Tsukoyachi/Domotech/code/Readme.md

Les librairies requises pour faire fonctionner le code "/Domotech_final/src/main.cpp" qui est actuellement la dernière version de notre projet sont les suivantes :
 - Adafruit Unified Sensor by Adafruit
 - DHT sensor library by Adafruit
 - ESP32Servo by Kevin Harrington
 - BH1750
 - AsyncTCP-esphome by Hristo Gochkov
 - ESPAsyncWebServer-esphome by ESPHome Team
