Tsukoyachi/Domotech/Oral final du projet/Présentation projet arduino.pptx

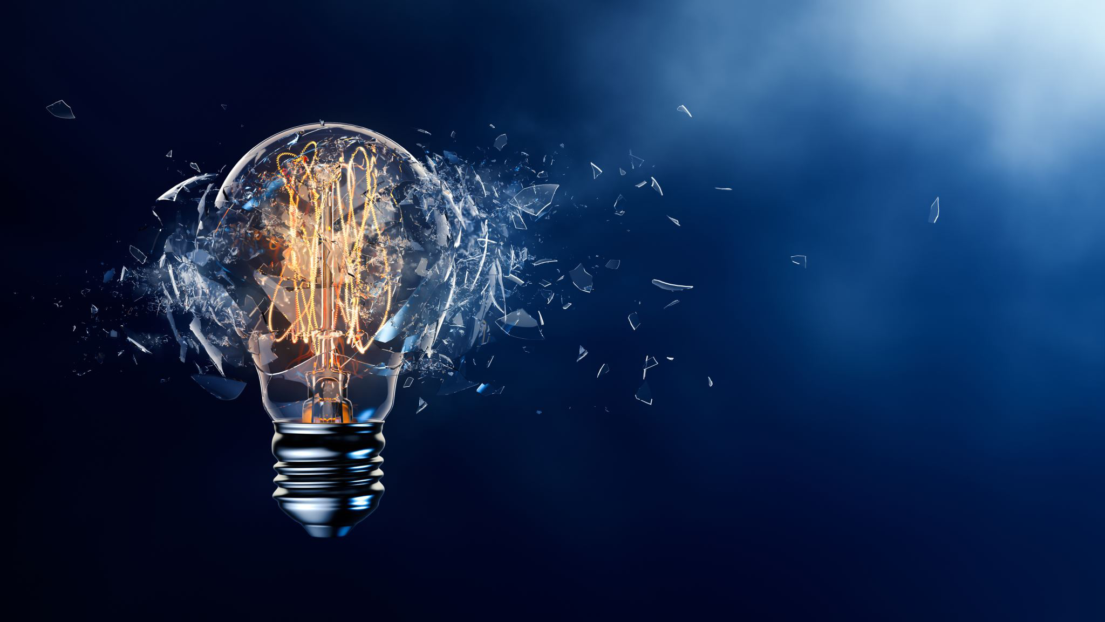
[picture p5: figure]
Une ampoule qui explose

Domotech
Axel Delille
Athéna Trastour--Lozano

La maison à notre façon

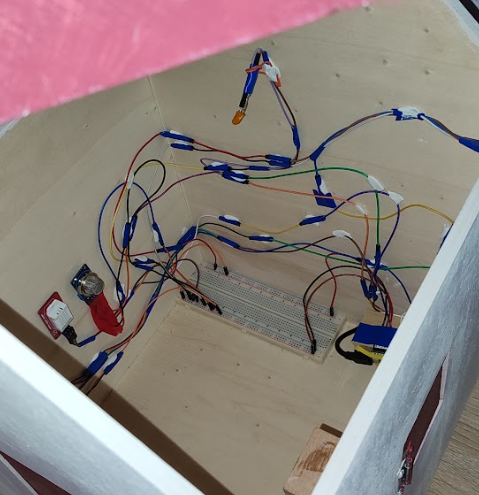
[picture p6: figure]
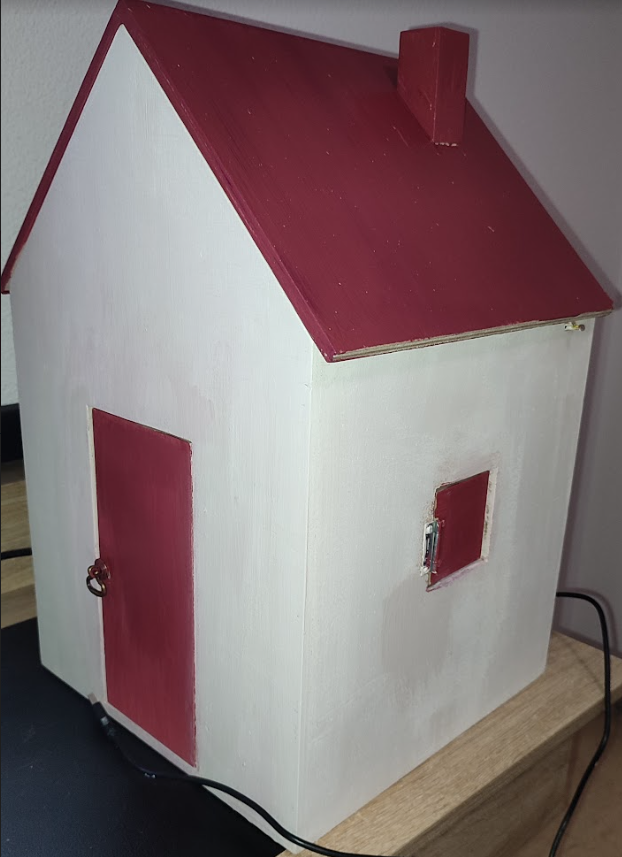
[picture p7: figure]

## Sommaire

- Introduction
- I/ Algorithme simplifié du projet
- II/ Liaison radiofréquence (WIFI)
- III/ Démonstration du projet
- Conclusion

## Introduction

La domotique représente l’ensemble des technologies liées à l’habitat permettant d’en améliorer le confort. Tout en l’automatisant et en facilitant les économies d’énergie.

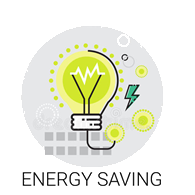
[picture p8: figure]
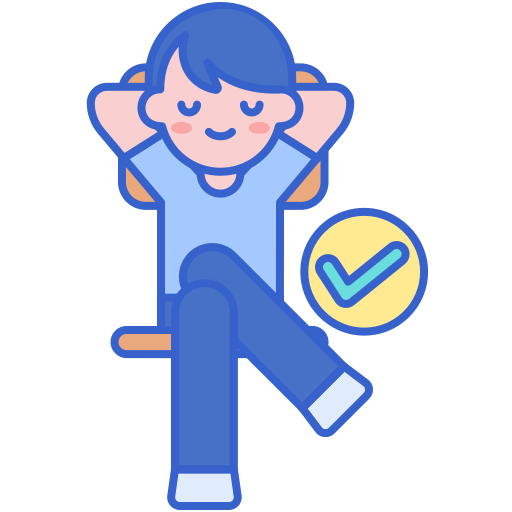
[picture p9: figure]
Confort - Icônes gens gratuites
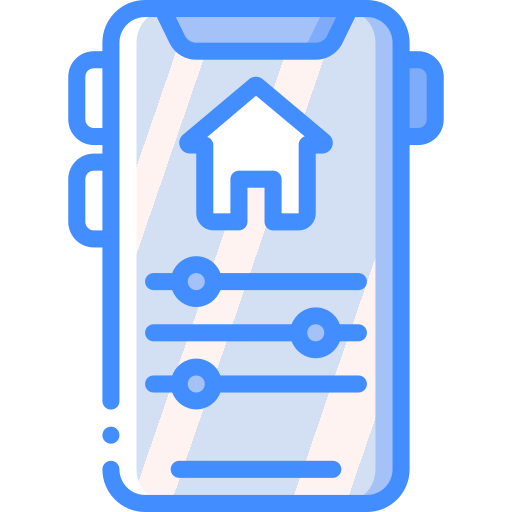
[picture p10: figure]
Domotique - Icônes la technologie gratuites

## Les composants du projet

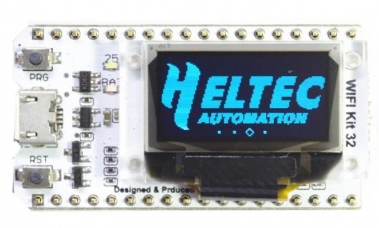
[picture p11: figure]

Microcontrôleur avec Wifi intégré, ESP32

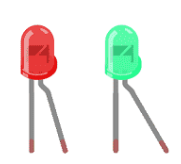
[picture p12: figure]
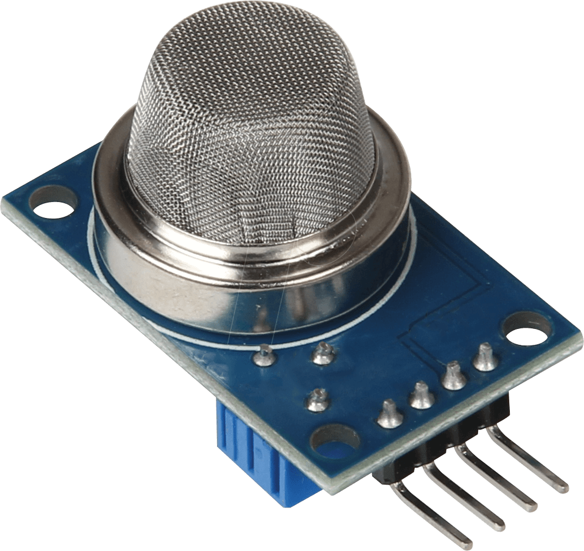
[picture p13: figure]
DEBO GAS2 MQ2: Cartes de développement - Capteur de gaz, gaz et fumée, MQ-2 chez reichelt elektronik

Capteur de gaz, MQ2

Une LED pour symboliser le chauffage et une LED pour la lumière.

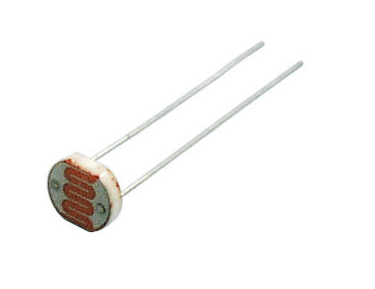
[picture p14: figure]
Photorésistance LDR720 - Photorésistances | GO TRONIC

Une photorésistance
qui joue le rôle de capteur de luminosité

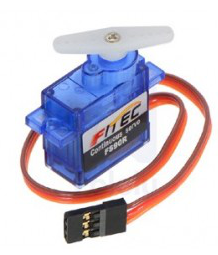
[picture p15: figure]
POL2820 servomoteur miniature à rotation continue pour arduino FS90R

Un servomoteur

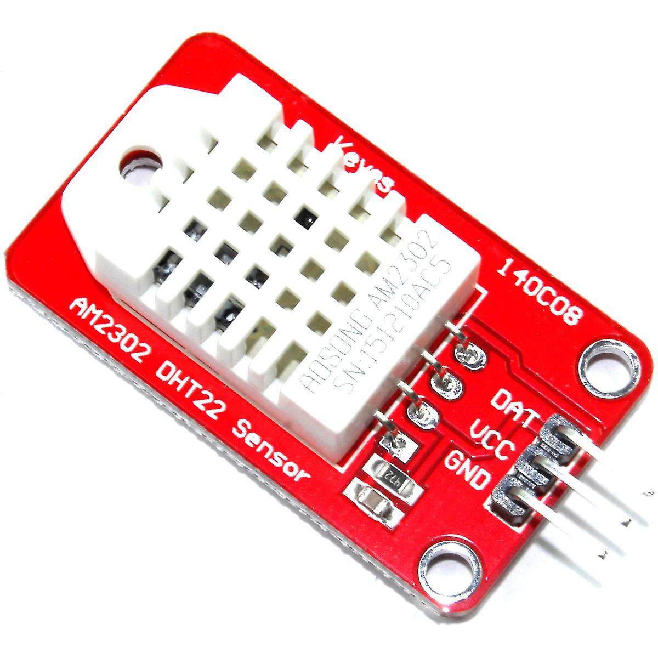
[picture p16: figure]
Keyes DHT22 Module capteur de température et d&amp;#39;humidité | Fruugo FR

Capteur de température,
DHT22

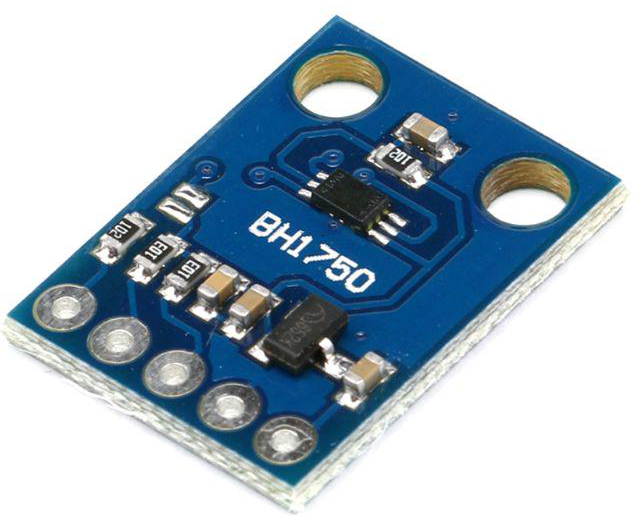
[picture p17: figure]
GY-302 BH1750 Module d&amp;#39;éclairage d&amp;#39;intensité lumineuse Module d&amp;#39;éclairage d&amp;#39;installation facile acheter à prix bas — livraison gratuite, avis réels avec des photos — Joom

Second capteur de luminosité,
BH1750

## Algorithme simplifié du projet

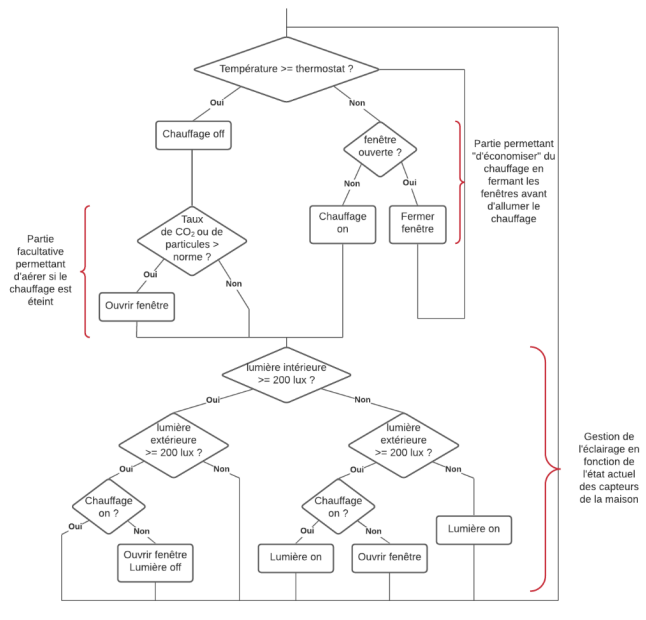
[picture p18: figure]

## Liaison radiofréquence (Wifi)

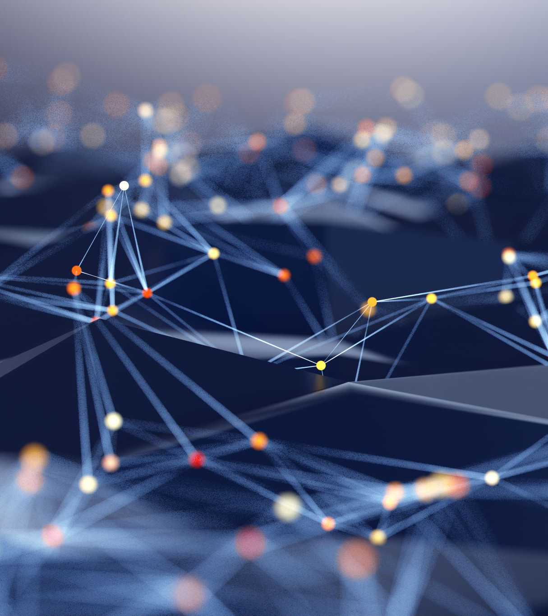
[picture p19: figure]
Lignes et points connectés sur cadre fil

- Le point d’accès réseau du projet :
  - Nom de réseau : Redmi Note 10 Pro
  - Mot de passe : Domotech
- URL du site du projet : 192.168.214.123

## Conclusion

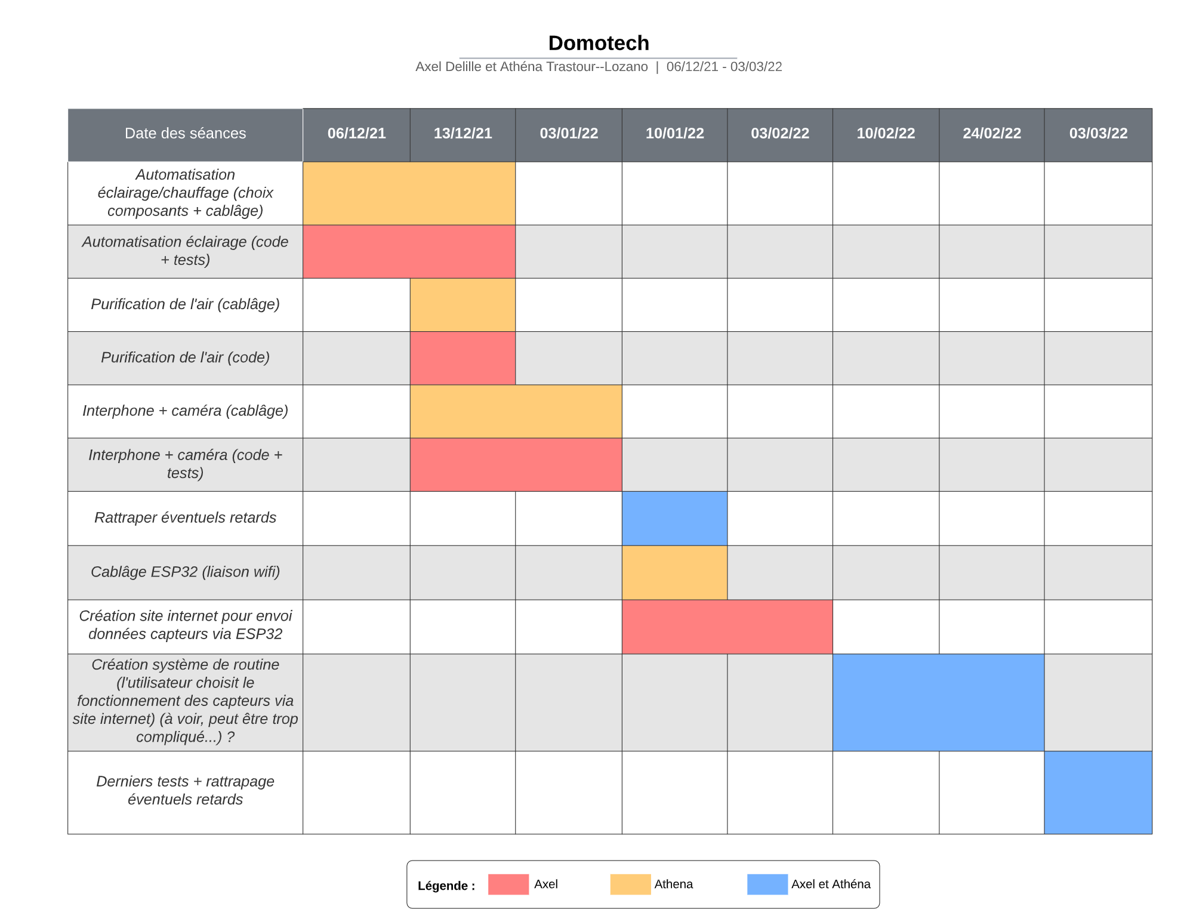
[picture p20: figure]

+ Ajout du contrôle total du thermostat et des actions de la maison via le site internet du projet.

Merci pour votre attention.
