Tsukoyachi/Domotech/Rapport séance Athéna Trastour--Lozano/RAPPORT_SEANCE6_TRASTOUR_G4_PEIP2.pdf

RAPPORT DE LA SEANCE 6

Dans la première partie de la séance, Axel et moi avons présenté notre projet lors de
l’« interview » filmée, ce qui a pris pas mal de temps (j’ai du répéter ma prise de parole deux fois à cause d’un problème de son).

L’objectif de cette séance a été de rendre fonctionnel le volet en bois extérieur (I.) de la maison domotique et de commencer la mise en forme des composants (II.) de la maison (les rendre plus « compactes »).

I. Fixation du servomoteur sur son support

Il y a eu des problèmes de rotation du servomoteur mais, finalement, le servomoteur réalise bien le mouvement vers l’avant pour ouvrir la fenêtre puis vers l’arrière pour fermer la fenêtre. J’ai alors pu fixer définitivement sur le support de bois le servomoteur à l’aide d’un pistolet à colle (sur l’image ci-dessous).

TRASTOUR--LOZANO Athéna

G4 PEIP2

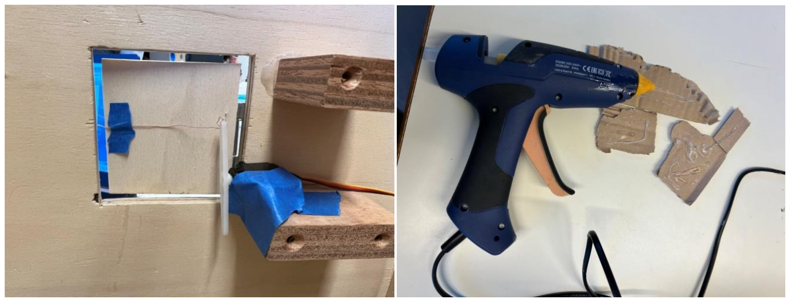
[picture p31: figure]

Servomoteur avant fixation

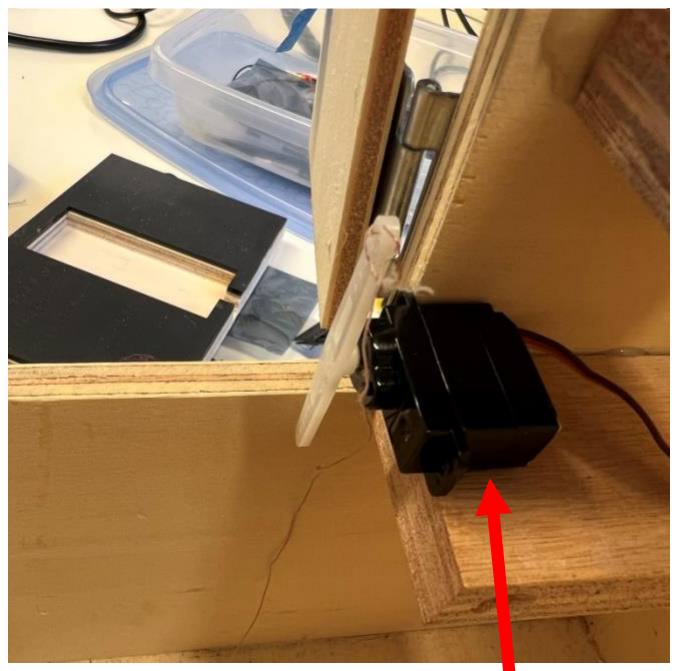
[picture p32: figure]

Servomoteur définitivement fixé à son support en bois

Pistolet à colle.

On voit que j’ai réalisé quelques « tests » sur les morceaux de carton avant de déposer la colle sur la face inférieur du servomoteur pour laisser écouler la colle qui n’était pas assez fluide/liquide au début.

II. Réalisation de deux soudures pour rendre plus « compactes » les composants

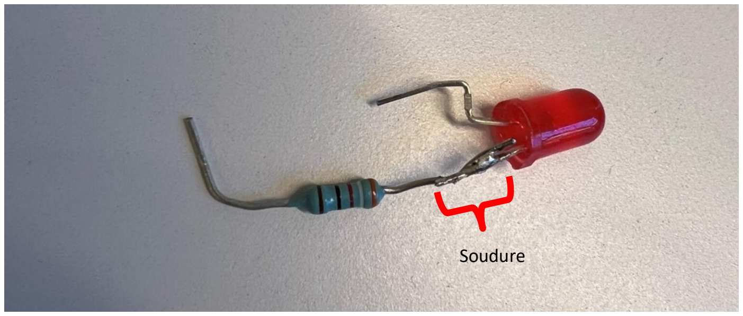
[picture p33: figure]
Soudure

J’ai fait exactement deux fois cette soudure entre LED et résistance de 392 Ohms :

LED 1 « lumière » - Résistance

LED 2 « chauffage » - Résistance

III. Mesures pour une future découpe dans du bois pour réaliser un support pour l’ESP32

Il faudra réaliser une découpe d’un rectangle de 5.5 cm de longueur et de 3.5 cm de largeur. Cette largeur sera nécessaire pour laisser la place aux câbles présents à la face arrière de l’ESP32. Celui-ci sera certainement fixé sur ce support en bois avec de la pâte à fixe.

| Schéma à l’échelle (vue du dessus) de la prochaine découpe pour l’ESP32 :

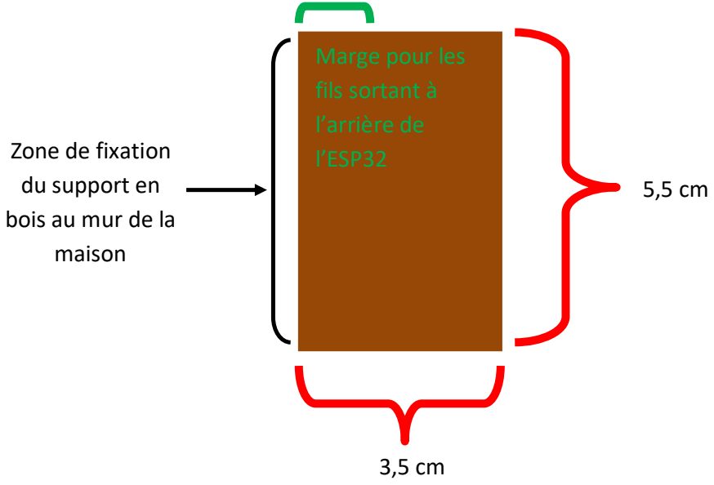
[picture p34: figure]
Marge pour les fils sortant à l’arrière de l’ESP32 Zone de fixation du support en bois au mur de la maison

IV. | Récapitulation des composants qui sont actuellement gardés pour le projet dans le tableau récapitulatif :
COMPOSANT | NUMERO SUR LA PHOTO | REFERENCE DU COMPOSANT | PLACEMENT DANS LA MAISON (contraintes soulignées)
Servomoteur pour ouverture des volets | 6 | MG91 | Fixé avec de la colle sur un carré de bois collé au mur intérieur droit de la maison
Capteur de luminosité (1) | 7 | GY-302/BH 1750 | à l’intérieur
Photorésistance, remplace le capteur de luminosité (2) | | | à l’extérieur
Capteur de température | 3 | AM2302 DHT22 Sensor | Fixé sur un mur intérieur à mi-hauteur (pas près du plafond) avec de la pâte à fixe
Capteur de C02 pour la qualité de l’air | 2 | MQ-2 Sensor | Fixé sur un mur intérieur avec pâte à fixe à hauteur humaine, pas près de la porte/fenêtre
ESP32 pour le site web | 5 | | Fixé à hauteur humaine de l’utilisateur sur le futur support de bois collé à un mur
LED 1 « lumière » | | | Fixée avec pate à fixe à un mur à une hauteur importante vers le plafond

LED 2 « chauffage »

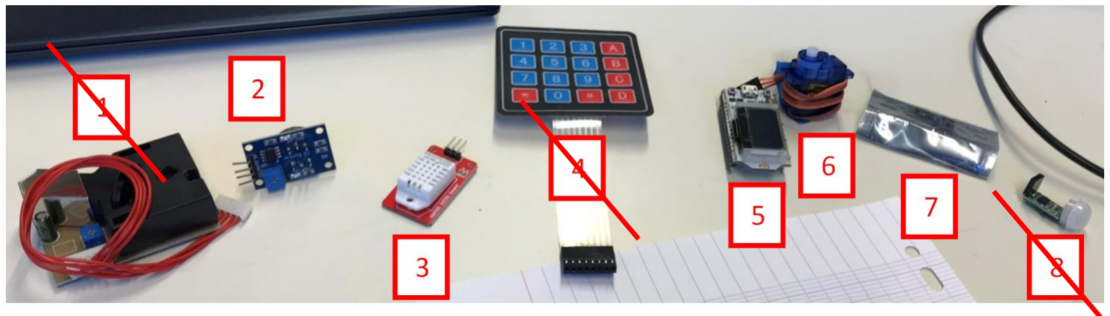
[picture p35: figure]
