Tsukoyachi/Domotech/Rapport séance Athéna Trastour--Lozano/RAPPORT_SEANCE4_TRASTOUR_G4_PEIP2.pdf

RAPPORT DE LA SEANCE 4

Les composants que j’ai utilisés aujourd’hui sont en vert dans le tableau récapitulatif :

COMPOSANT | NUMERO SUR LA PHOTO | REFERENCE DU COMPOSANT | Placement dans la maison
Servomoteur pour ouverture des volets | 6 | MG91 | Sur un carré de bois collé au mur extérieur en dessous de l’ouverture de la maison
Capteur de luminosité | 7 | GY-302/BH 1750 | (1) à l’intérieur
Photorésistance | | | à l’extérieur, remplace le capteur de luminosité (2)
Capteur de température | 3 | AM2302 DHT22 Sensor | Fixé sur un mur intérieur à mi-hauteur (pas près du plafond) avec de la pâte à fixe
Capteur de particules pour la qualité de l’air | 1 | Infrared Dust Sensor Module M501A Air Detection Sensor Air Quality Tester | Fixé sur un mur intérieur au niveau d’une hotte avec de la pâte à fixe (coin « cuisine »)
Capteur de C02 pour la qualité de l’air | 2 | MQ-2 Sensor | Fixé sur un mur intérieur avec pâte à fixe à hauteur humaine, pas près de la porte/fenêtre
Digicode | 4 | ZRX-543 | Fixé sur le mur extérieur à hauteur humaine avec de la pâte à fixe côté gauche/droit de la porte d’entrée
Capteur de présence | 8 | 1652 | Fixé sur le mur extérieur à hauteur humaine avec de la pâte à fixe côté gauche/droit de la porte d’entrée
ESP32 pour le site web | 5
LED | | | Fixée avec du scotch ou de la pate à fixe au plafond

TRASTOUR--LOZANO Athéna

G4 PEIP2

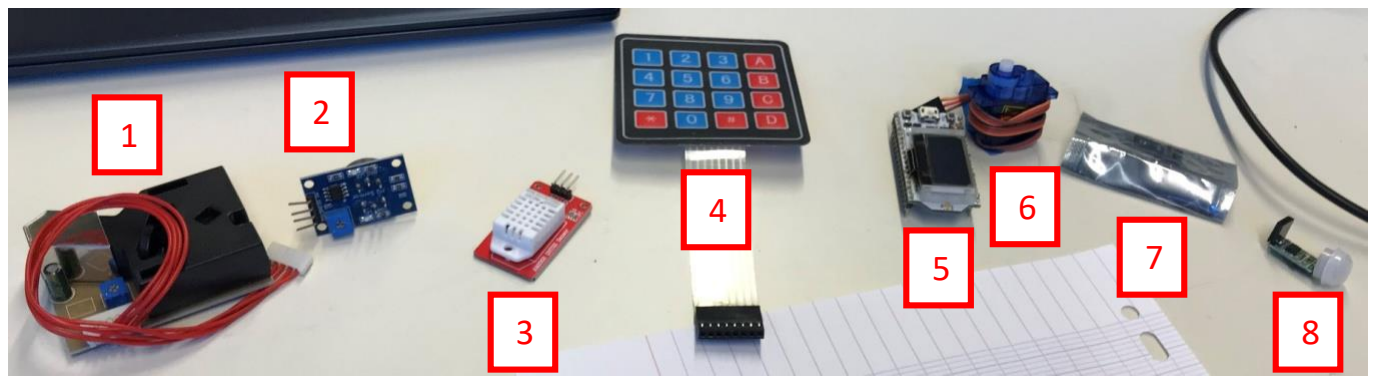
[picture p42: figure]

Dans le tableau ci-dessus, une modification est à noter. Le deuxième capteur de luminosité (2), celui devant être à l’extérieur est remplacé par une photorésistance. (Sa résistance variant en fonction de la lumière perçue, il est ainsi possible d’obtenir des valeurs en lux pour la luminosité extérieure grâce à cette photorésistance).

I. Détermination d’une valeur seuil pour le capteur de particules

Ce capteur utilise une méthode de comptage pour mesurer la concentration en poussières, (pas une méthode de pesée), et l'unité est pcs/L (pièces par litre).
La plage de concentration détectable s’étend de 0 à 28 000 pièces/L.
Voici un graphique de la concentration en poussières mesurée dans un bureau :

D’après ce graphique, on voit que la concentration en particules est bien plus élevée dans les horaires de travail de l’après-midi. On décide de choisir comme valeur seuil à ne pas dépasser pour notre maison celle de 2 000 pièces/L.

Concentration
(pièces/L)

II. Test du fonctionnement du capteur de présence (avec le code mis sur Github « capteur_presence »)

Rappel du câblage :

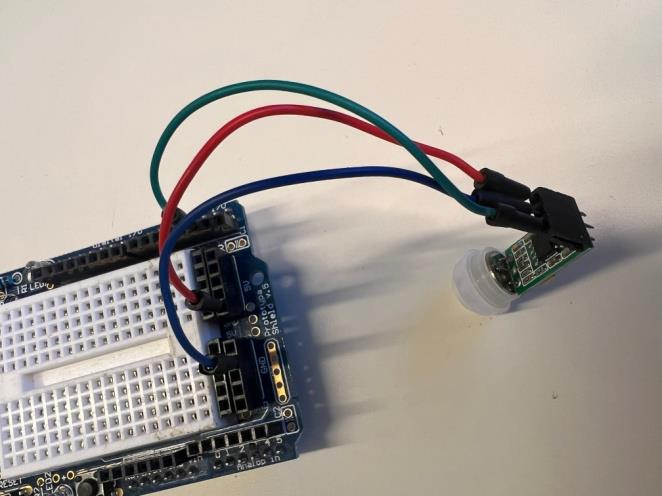
[picture p43: figure]

Pin de sortie : 2, GND, 5V

Code :

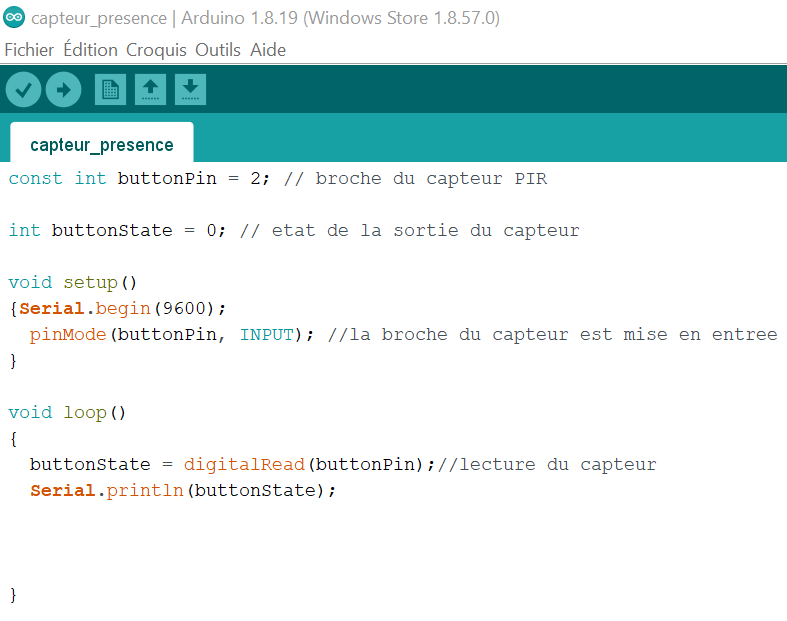
[picture p44: figure]

Test avec affichage sur le moniteur série :

Le moniteur renvoi bien l’état LOW « 0 » tout le temps sauf quand je passe ma main devant le capteur pour créer un mouvement par exemple, l’état HIGH « 1 » est bien renvoyé.

III. Test du fonctionnement du digicode (avec le code mis sur Github « digicode »)

Rappel du câblage :

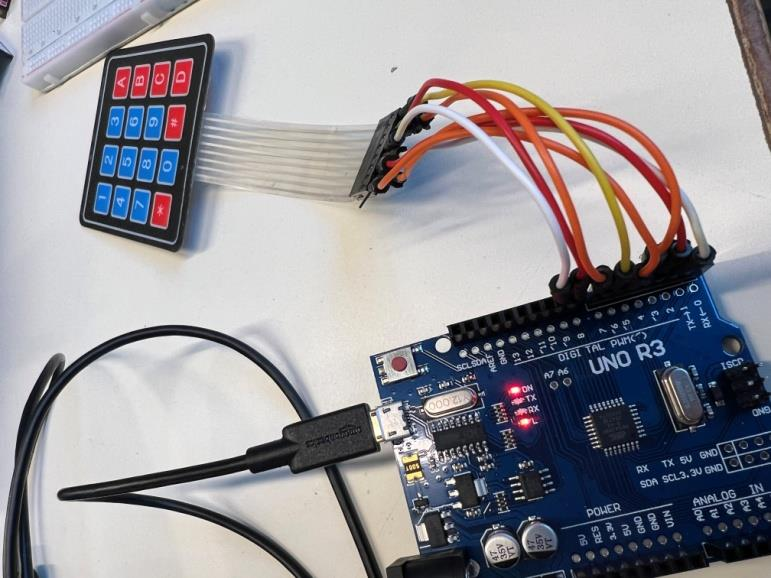
[picture p45: figure]

En m’aidant de ce site : https://www.instructables.com/Connecting-a-4-x-4-Membrane-Keypad-to-an-Arduino/ (https://www.instructables.com/Connecting-a-4-x-4-Membrane-Keypad-to-an-Arduino/)

Après avoir installé la bibliothèque « Keypad », j’ai pu tester le bon fonctionnement du digicode. En effet, j’ai vérifié que, sur le terminal, chaque symbole de la touche que j’ai enfoncée apparait sur le moniteur série de l’IDE Arduino.

Code :

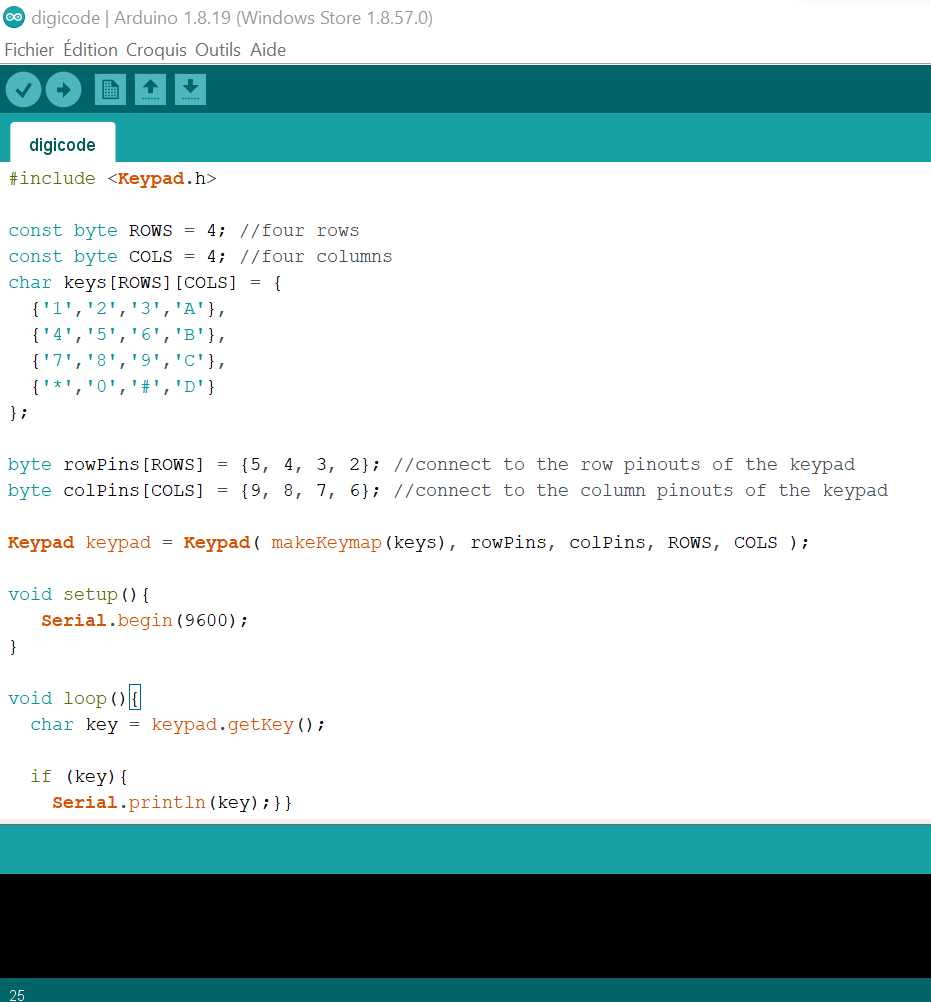
[picture p46: figure]

Test avec affichage sur le moniteur série :

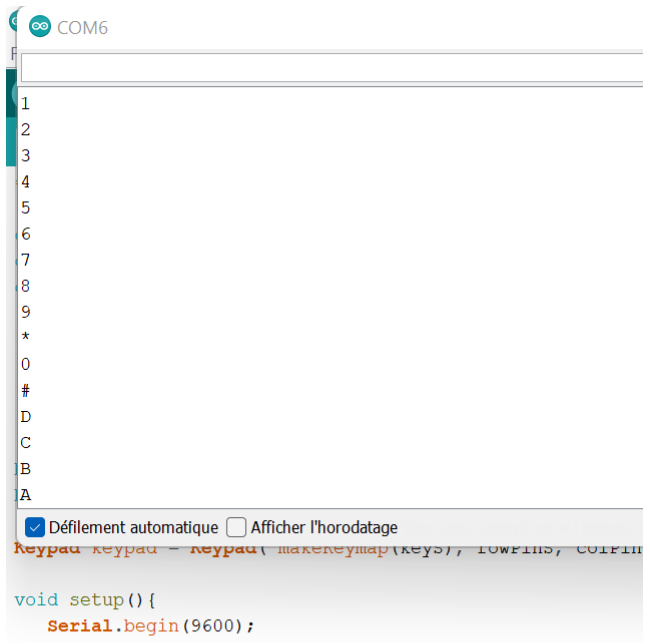
[picture p47: figure]
