Tsukoyachi/Domotech/Rapport séance Axel Delille/README.md

This folder will contain all end-of-session reports by Axel Delille.
_________________________________________________________________________

Ce dossier contiendra tous les rapports de fin de séance d'Axel Delille.
