Tsukoyachi/Domotech/Rapport séance Athéna Trastour--Lozano/README.md

This folder will contain all end-of-session reports by Athéna Trastour--Lozano.
___________________________________________________________________________________

Ce dossier contiendra tous les rapports de fin de séance d'Athéna Trastour--Lozano.
