Tsukoyachi/Domotech/Oral final du projet/README.md

Dans ce dossier est contenu le diaporama de la soutenance finale de projet.
___________________________________________________________________________

This folder contains the slide show of the final project presentation.

# Here is a link to a video demonstration of the project :
https://www.youtube.com/watch?v=h6xsl7u4DOc&list=PLZiidj2X6S_mYPlfseCMSw44s1h56aiDF&index=2
