Tsukoyachi/Domotech/Diagramme de Gantt Domotech.pdf

## Domotech

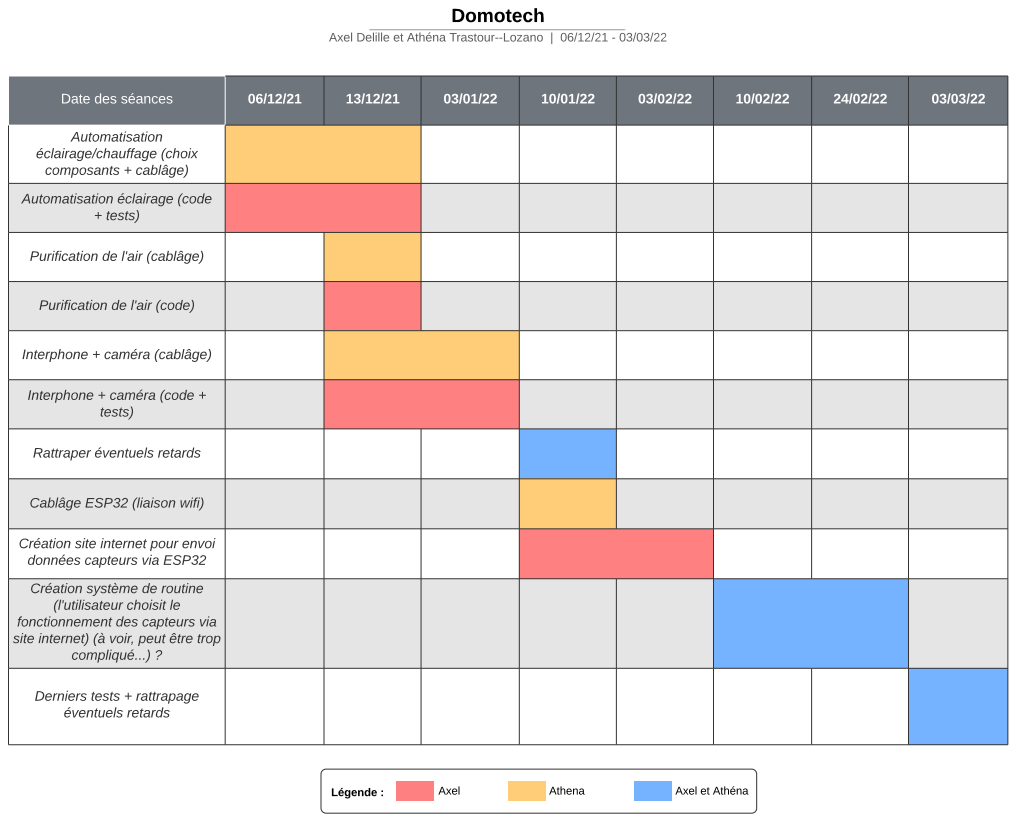
[picture p71: page 1]
Légende :; Axel; Athena; Axel et Athéna; Axel Delille et Athéna Trastour--Lozano

Date des séances | 06/12/21 | 13/12/21 | 03/01/22 | 10/01/22 | 03/02/22 | 10/02/22 | 24/02/22 | 03/03/22

Automatisation éclairage/chauffage (choix composants + cablâge)

Automatisation éclairage (code + tests)

Purification de l'air (cablâge)

Purification de l'air (code)

Interphone + caméra (cablâge)

Interphone + caméra (code + tests)

Rattraper éventuels retards

Cablâge ESP32 (liaison wifi)

Création site internet pour envoi données capteurs via ESP32

Création système de routine (l'utilisateur choisit le fonctionnement des capteurs via site internet) (à voir, peut être trop compliqué...) ?

Derniers tests + rattrapage éventuels retards
