Tsukoyachi/Domotech/(commit log)

2021-12-13 Add files via upload
    Première fusion de code entre luminosité et température.
2022-03-04 Update main.cpp
    Modification of the servomotor in the project, and modification of the pin associated to it, the new servomotor turn in the other way so I need to change the angle associated to it, instead of going between 90 and 180 ° he goes between 0 and 100°.
2022-03-09 - fixing of a bug where temperature is not a number
    [main.cpp]
